mduomarco-sketch/engranaje/STEP/engranaje.step

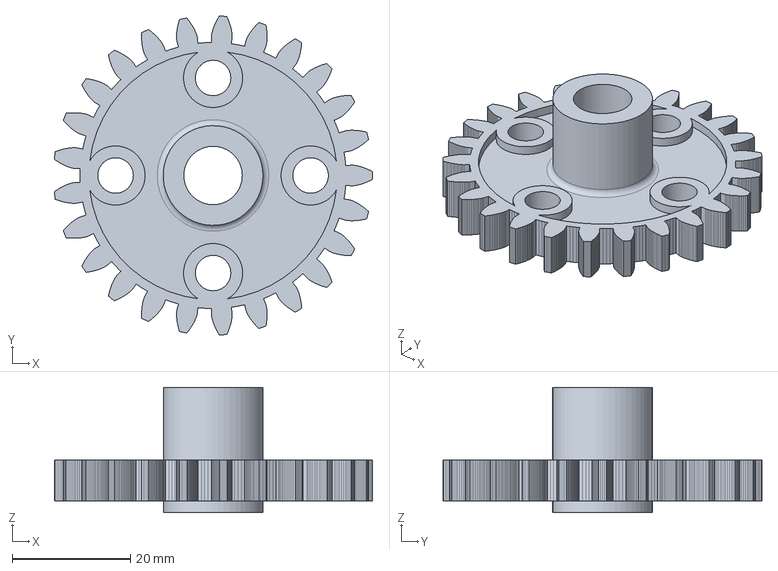
[picture p8: CAD file, 2026-10-13]
STEP/engranaje.step
53.9 x 54.0 x 21.2 mm
