mduomarco-sketch/engranaje/(list of files, cad)

Other CAD files:
3MF/engranaje.3mf
STL/engranaje.stl
