mduomarco-sketch/engranaje/(commit log)

2026-10-13 Engranaje de recambio: modelo, archivos de impresión y README del proceso
    [engranaje.3mf, engranaje.step, engranaje.stl]
2026-10-13 Aclarar detalles en el README
2026-10-13 Modelo en build123d puro y README actualizado
    [engranaje.step, engranaje.stl]
